rharrison/T962A-UpgradeBoard/images/T962A-UpgradeBoard-Top.png

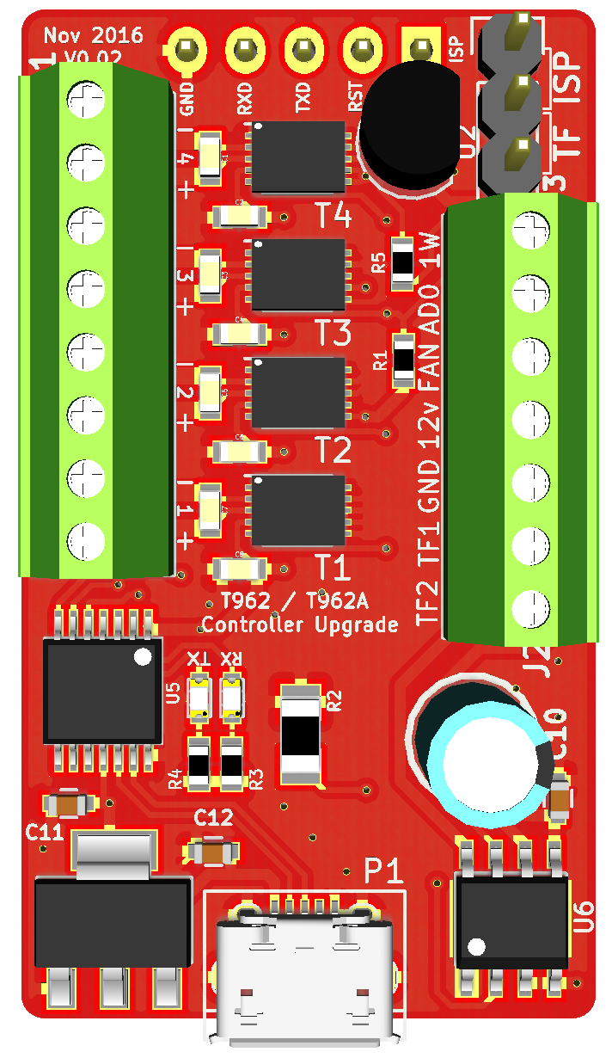
images/T962A-UpgradeBoard-Top.png
