rharrison/T962A-UpgradeBoard/images/T962A-UpgradeBoard-front.png

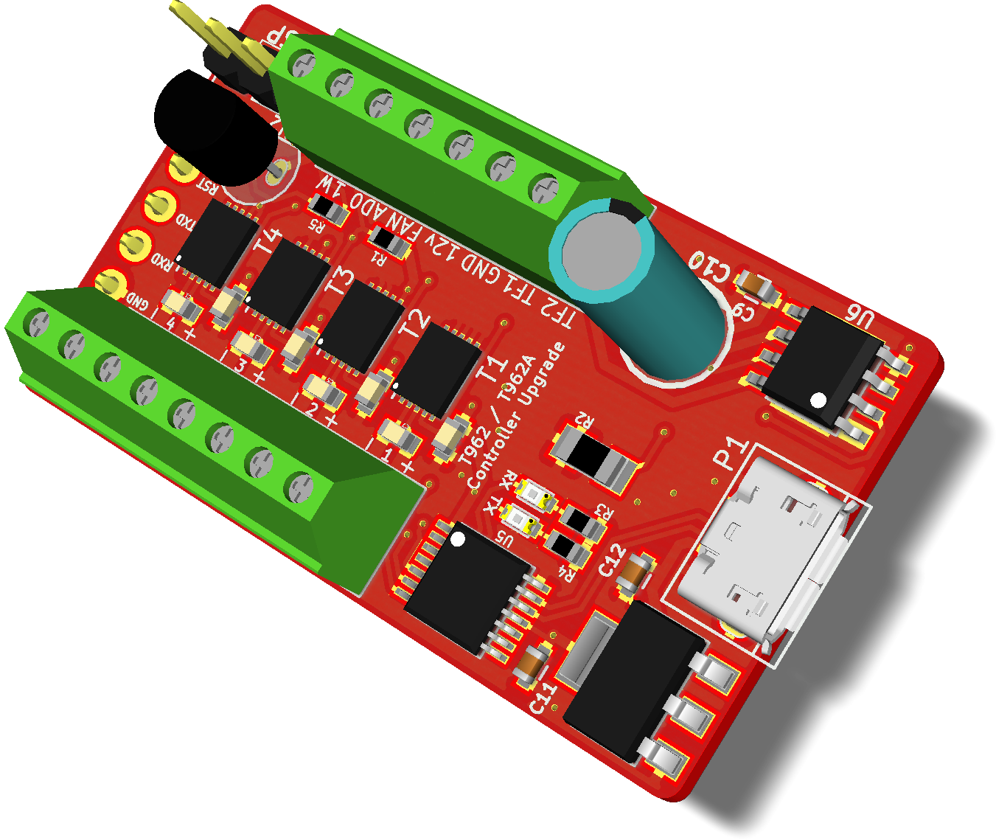
images/T962A-UpgradeBoard-front.png
