rharrison/T962A-UpgradeBoard/images/T962A-UpgradeBoard-Labeled.png

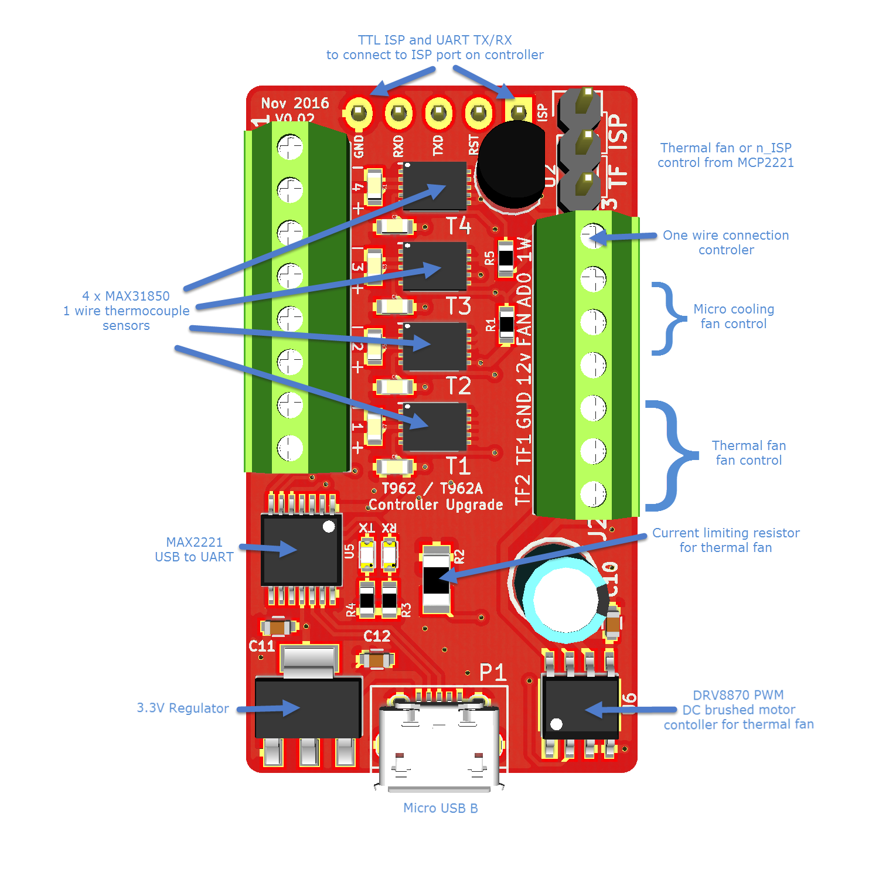
images/T962A-UpgradeBoard-Labeled.png
