rharrison/T962A-UpgradeBoard/images/T962A-UpgradeBoard-Rear.png

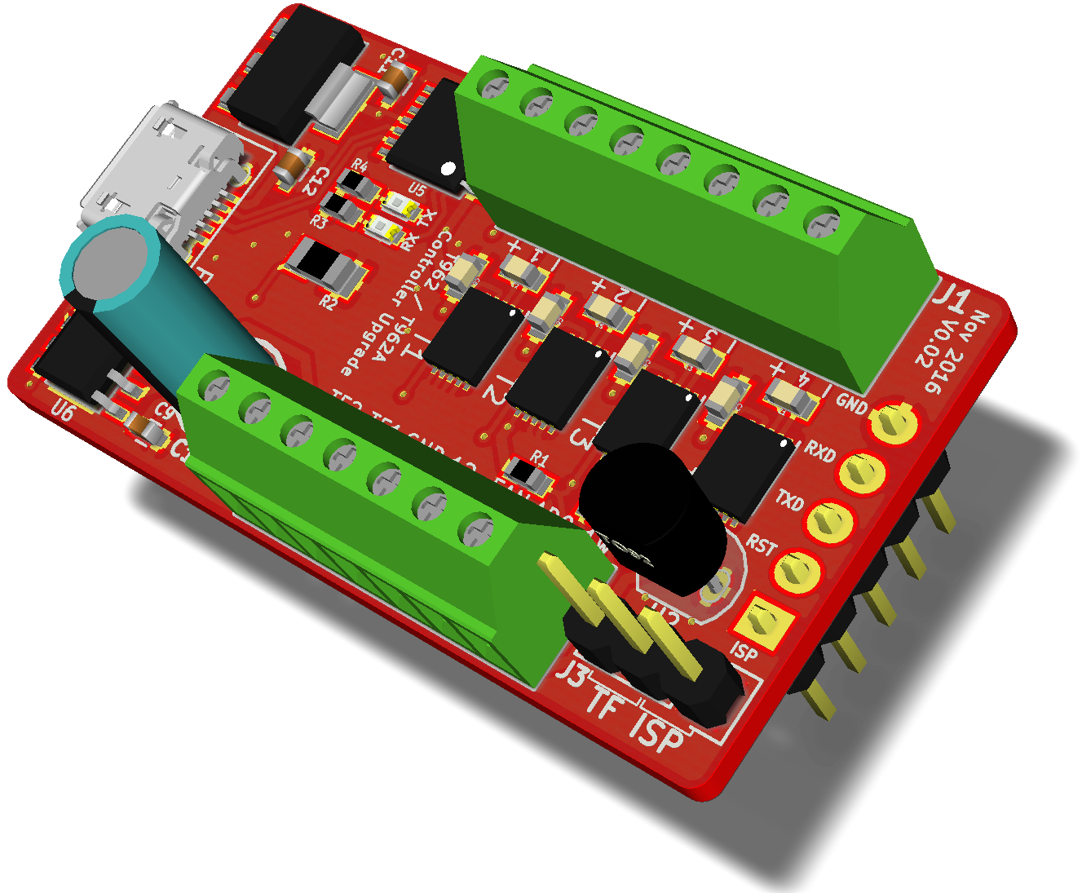
images/T962A-UpgradeBoard-Rear.png
