rharrison/T962A-UpgradeBoard/T962A-UpgradeBoard.kicad_pcb

## KiCad design T962A-UpgradeBoard.kicad_pcb (2016-11-17)

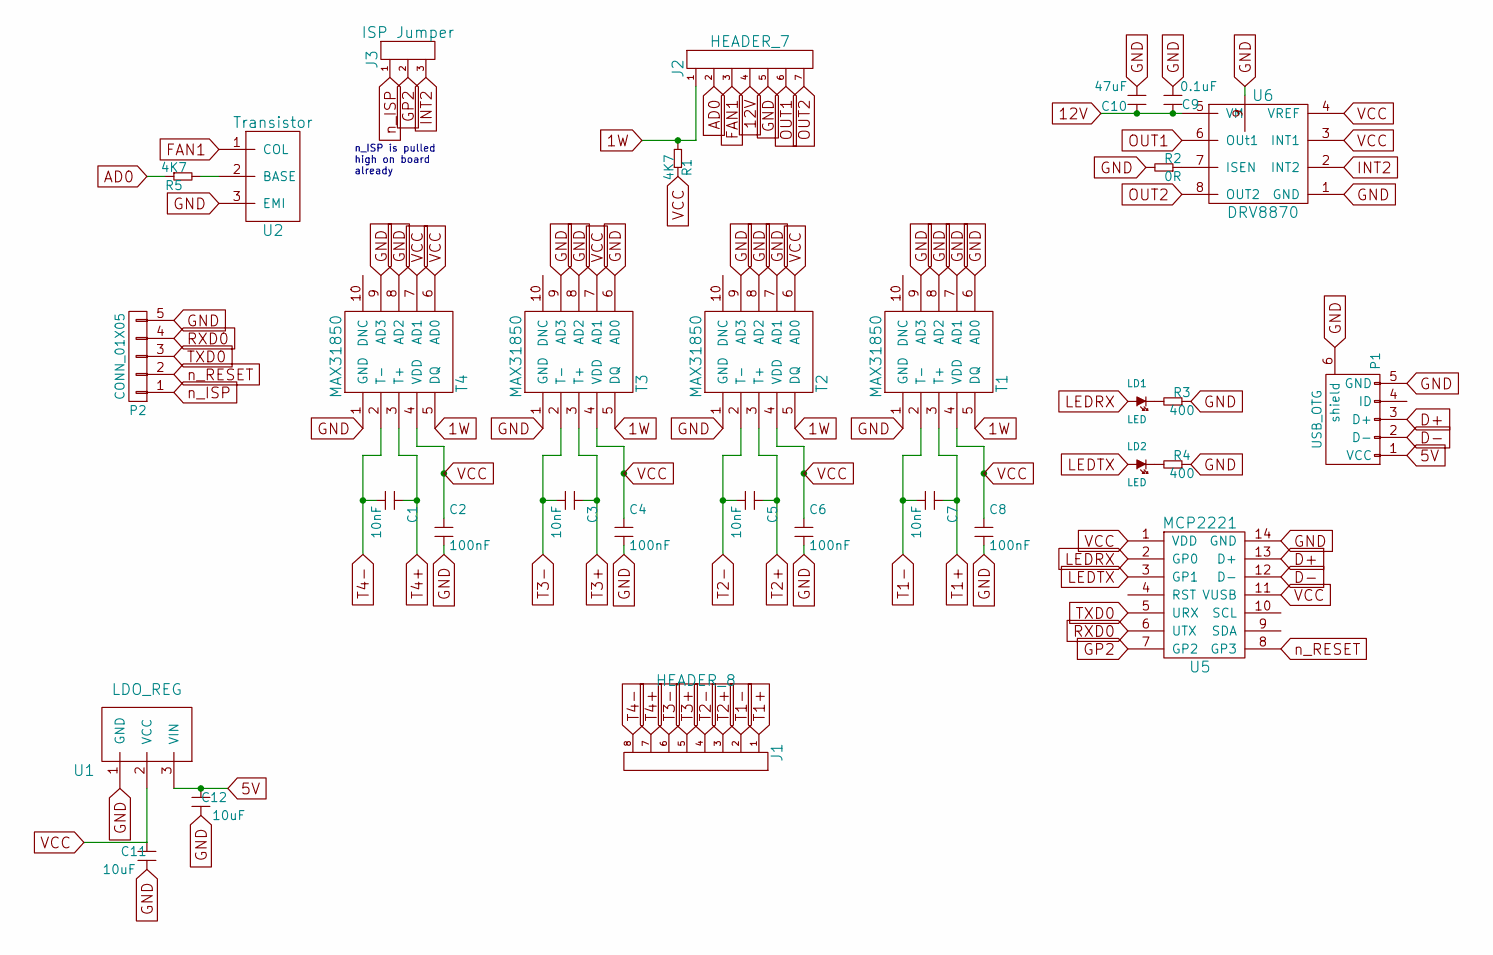
[picture p5: schematic T962A-UpgradeBoard.sch]

Parts:
C1, C3, C5, C7: 10nF; c_0603
C2, C4, C6, C8: 100nF; c_0603
C9: 0.1uF; C_0603
C10: 47uF; CP_5x11mm
C11, C12: 10uF; C_0603
J1: HEADER_8; mpt_0,5%2f8-2,54
J2: HEADER_7; mpt_0,5%2f7-2,54
J3: ISP Jumper; Pin_Header_Straight_1x03
LD1, LD2: LED; Led_0603
P1: USB_OTG; USB_Micro-B
P2: CONN_01X05; Pin_Header_Straight_1x05
R1, R5: 4K7; r_0603
R2: 0R; r_1206
R3, R4: 400; r_0603
T1, T2, T3, T4: MAX31850; MAX31850_MAX31851_TDFN_EP
U1: LDO_REG; sot223
U2: Transistor; TO-92_Inline_Narrow_Oval
U5: MCP2221; tssop-14
U6: DRV8870; HSOP-8

Connections:
1W: J2.1, R1.2, T1.5 (DQ), T2.5 (DQ), T3.5 (DQ), T4.5 (DQ)
5V: C12.1, P1.1 (VCC), U1.3 (VIN)
12V: C9.1, C10.1, J2.4, U6.5 (VM)
AD0: J2.2, R5.1
D+: P1.3 (D+), U5.13 (D+)
D-: P1.2 (D-), U5.12 (D-)
FAN1: J2.3, U2.1 (COL)
GND: C2.2, C4.2, C6.2, C8.2, C9.2, C10.2, C11.2, C12.2, J2.5, P1.5 (GND), P1.6 (shield), P2.5, R2.2, R3.1, R4.1, T1.1 (GND), T1.6 (AD0), T1.7 (AD1), T1.8 (AD2), T1.9 (AD3), T2.1 (GND), T2.7 (AD1), T2.8 (AD2), T2.9 (AD3), T3.1 (GND), T3.6 (AD0), T3.8 (AD2), T3.9 (AD3), T4.1 (GND), T4.8 (AD2), T4.9 (AD3), U1.1 (GND), U2.3 (EMI), U5.14 (GND), U6.1 (GND), U6.9
GP2: J3.2, U5.7 (GP2)
INT2: J3.3, U6.2 (INT2)
LEDRX: LD1.1 (A), U5.2 (GP0)
LEDTX: LD2.1 (A), U5.3 (GP1)
unnamed: LD1.2 (K), R3.2
unnamed: LD2.2 (K), R4.2
unnamed: R2.1, U6.7 (ISEN)
unnamed: R5.2, U2.2 (BASE)
OUT1: J2.6, U6.6 (OUt1)
OUT2: J2.7, U6.8 (OUT2)
RXD0: P2.4, U5.6 (UTX)
T1+: C7.1, J1.1, T1.3 (T+)
T1-: C7.2, J1.2, T1.2 (T-)
T2+: C5.1, J1.3, T2.3 (T+)
T2-: C5.2, J1.4, T2.2 (T-)
T3+: C3.1, J1.5, T3.3 (T+)
T3-: C3.2, J1.6, T3.2 (T-)
T4+: C1.1, J1.7, T4.3 (T+)
T4-: C1.2, J1.8, T4.2 (T-)
TXD0: P2.3, U5.5 (URX)
VCC: C2.1, C4.1, C6.1, C8.1, C11.1, R1.1, T1.4 (VDD), T2.4 (VDD), T2.6 (AD0), T3.4 (VDD), T3.7 (AD1), T4.4 (VDD), T4.6 (AD0), T4.7 (AD1), U1.2 (VCC), U5.1 (VDD), U5.11 (VUSB), U6.3 (INT1), U6.4 (VREF)
n_ISP: J3.1, P2.1
n_RESET: P2.2, U5.8 (GP3)

Notes on the sheet:
n_ISP is pulled high on board already

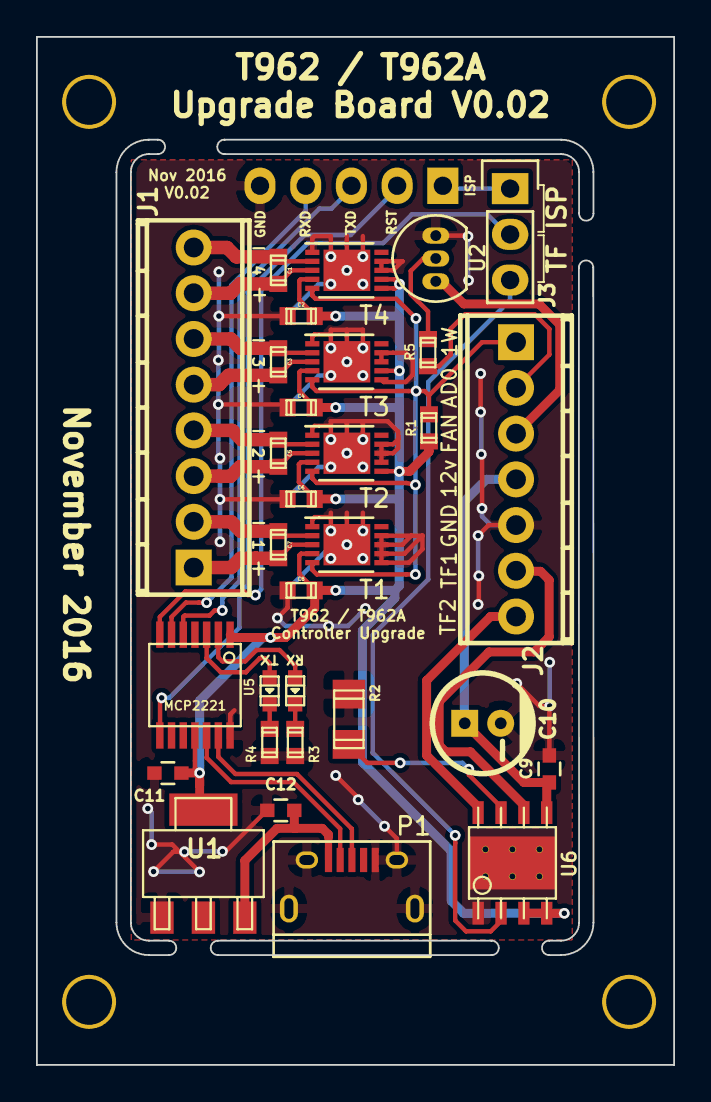
[picture p6: board T962A-UpgradeBoard.kicad_pcb from above]

Board: 2 copper layers, 35.4 x 57.1 mm, 32 parts (1 on the bottom side), 31 nets.
