rharrison/T962A-UpgradeBoard/(threads)

Thread 1 (2019-03-24):

Is this the latest revision?

jdeglavina, 2019-03-24:
I noticed this version in your YouTube video is different from the one on on here in that it has a 3.3v header. Was that added to allow things to operate without the usb connection?

rharrison, 2020-03-16:
If you want to operate the oven without having a powered USB connection attached to the oven then there are two options; either bridge the R7 resistor pads with the supplied 0R 0603 resistor or a blob of solder or a short bit of wire. The second option is to cut the trace on the bottom of the board which goes to the RST pin as this is only needed to program the oven for the first time with the new firmware. Once you have reprogrammed the oven you can enter programming mode by holding down the F1 key during power up.

bgrigoriu, 2021-05-19:
Hi,
First thaks for the work and the shafing really amazing.
Wanted to implement  a MAX31850/31855 board ( will build both for fun and test) BUT
I  Noticed that we used the GP2/GP3  outputs of your MAX 2221 for programming and (I suppose) get rid of the manual procedure of ISP/reset.

Q1: Which flasing software support this.
Q2: Does it extenssible to the USB/uART chips( I have some FT232 and CH340)
 Thank you again

rharrison, 2021-05-19:
Ahh yes. It comes back to me! The Software on the website for the MCP2221 allows you to set the pin values for programming the T962A. If there are GPIO ports on the FT232 the. You should be able to use those.

Sent from my iPad

On 19 May 2021, at 07:00, bgrigoriu ***@***.***> wrote:

External

Hi,
First thaks for the work and the shafing really amazing.
Wanted to implement a MAX31850/31855 board ( will build both for fun and test) BUT
I Noticed that we used the GP2/GP3 outputs of your MAX 2221 for programming and (I suppose) get rid of the manual procedure of ISP/reset.

Q1: Which flasing software support this.
Q2: Does it extenssible to the USB/uART chips( I have some FT232 and CH340)
Thank you again

—
You are receiving this because you commented.
Reply to this email directly, view it on GitHub<https://eur03.safelinks.protection.outlook.com/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>, or unsubscribe<https://eur03.safelinks.protection.outlook.com/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>.

________________________________

This email has been scanned by the HGF email filtering system for spam & viruses. If you believe this email should have been stopped by our filters, click here<https://eur03.safelinks.protection.outlook.com/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> to report it.

bgrigoriu, 2021-05-19:
Hi,

Thanks

The FT232 does not have GPIO.
If  I understood correctly you are using the Microchip utility on their website.

And I was just wondering if I can use this through the DTR /RTS signal as in the manual of the Philips flash utility.

________________________________
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

rharrison, 2021-05-19:
Yep the Microchip utility 👍

I tried DTR/RST without any success. Give it a go and let me know how you get on.

Sent from my iPad

On 19 May 2021, at 11:58, bgrigoriu ***@***.***> wrote:

External

Hi,

Thanks

The FT232 does not have GPIO.
If I understood correctly you are using the Microchip utility on their website.

And I was just wondering if I can use this through the DTR /RTS signal as in the manual of the Philips flash utility.

________________________________
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
