rharrison/T962A-UpgradeBoard/(commit log)

2016-11-10 Version 0.02 Signed-off-by: Robert Harrison <rharrison@hgf.com>
    [T962A-UpgradeBoard-B.Cu.gbl, T962A-UpgradeBoard-B.Mask.gbs, T962A-UpgradeBoard-B.SilkS.gbo, T962A-UpgradeBoard-Edge.Cuts.gm1, T962A-UpgradeBoard-F.Cu.gtl, T962A-UpgradeBoard-F.Mask.gts, T962A-UpgradeBoard-F.Paste.gtp, T962A-UpgradeBoard-F.SilkS.gto]
2016-11-17 T962 Images Updated
    [T962A-UpgradeBoard-B.Cu.gbl, T962A-UpgradeBoard-B.Mask.gbs, T962A-UpgradeBoard-B.SilkS.gbo, T962A-UpgradeBoard-Edge.Cuts.gm1, T962A-UpgradeBoard-F.Cu.gtl, T962A-UpgradeBoard-F.Mask.gts, T962A-UpgradeBoard-F.Paste.gtp, T962A-UpgradeBoard-F.SilkS.gto]
